aidancostello/ECE395_Project/README.md

# ECE395_Project

See report for directory layout and other information.
