aidancostello/ECE395_Project/Hardware/TrackingTurrentBoard/TrackingTurrentBoard.pdf

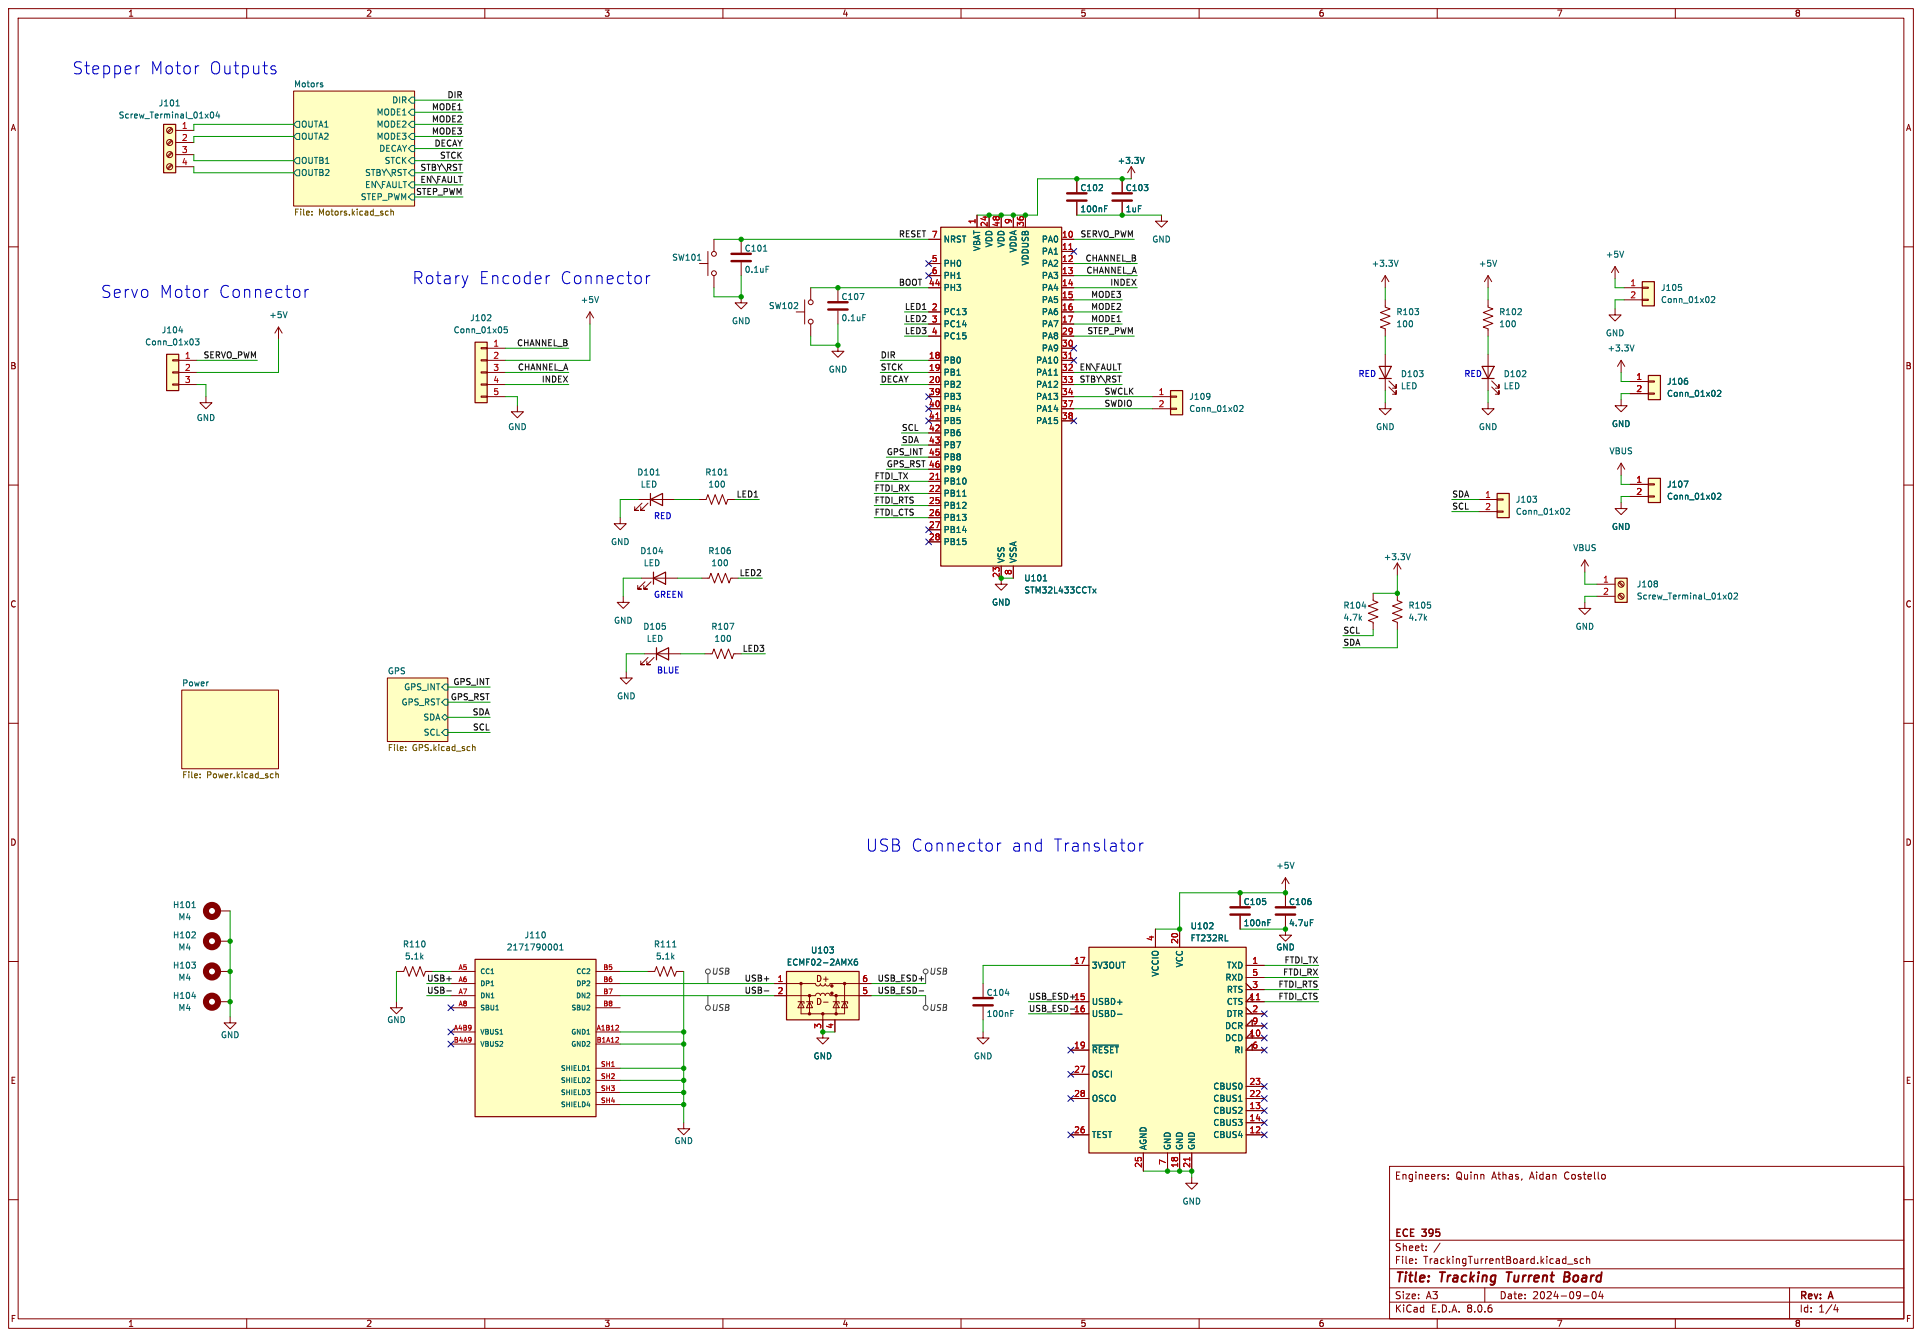
[picture p1: page 1]

EN\FAULT STBY\RST DIR
STCK MODE2 MODE1 STEP_PWM

1 PA0 10 PA1 11 PA2 12 PA3 13 PA4 14 PA5 15 PA6 16 PA7 17 PB0 18 PB1 19 PC13 2 PB2 20 PB10 21 PB11 22 VSS 23 VDD 24 PB12 25 PB13 26 PB14 27 PB15 28 PA8 29 PC14 3 PA9 30 PA10 31 PA11 32 PA12 33 PA13 34 VDDUSB 36 PA14 37 PA15 38 PB3 39 PC15 4 PB4 40 PB5 41 PB6 42 PB7 43 PH3 44 PB8 45 PB9 46 VDD 48 PH0 5 PH1 6 NRST 7 VSSA

9 U102 FT232RLTXD 1 DCD 10 CTS 11 CBUS4 12 CBUS2 13 CBUS3 14 USBD+ 15 USBD- 16

STBY\RST MODE2 EN\FAULT STEP_PWM

File: GPS.kicad_sch Power File: Power.kicad_sch

File: TrackingTurrentBoard.kicad_sch Sheet: / ECE 395 Engineers: Quinn Athas, Aidan Costello

Id: 1/4 Title: Tracking Turrent Board

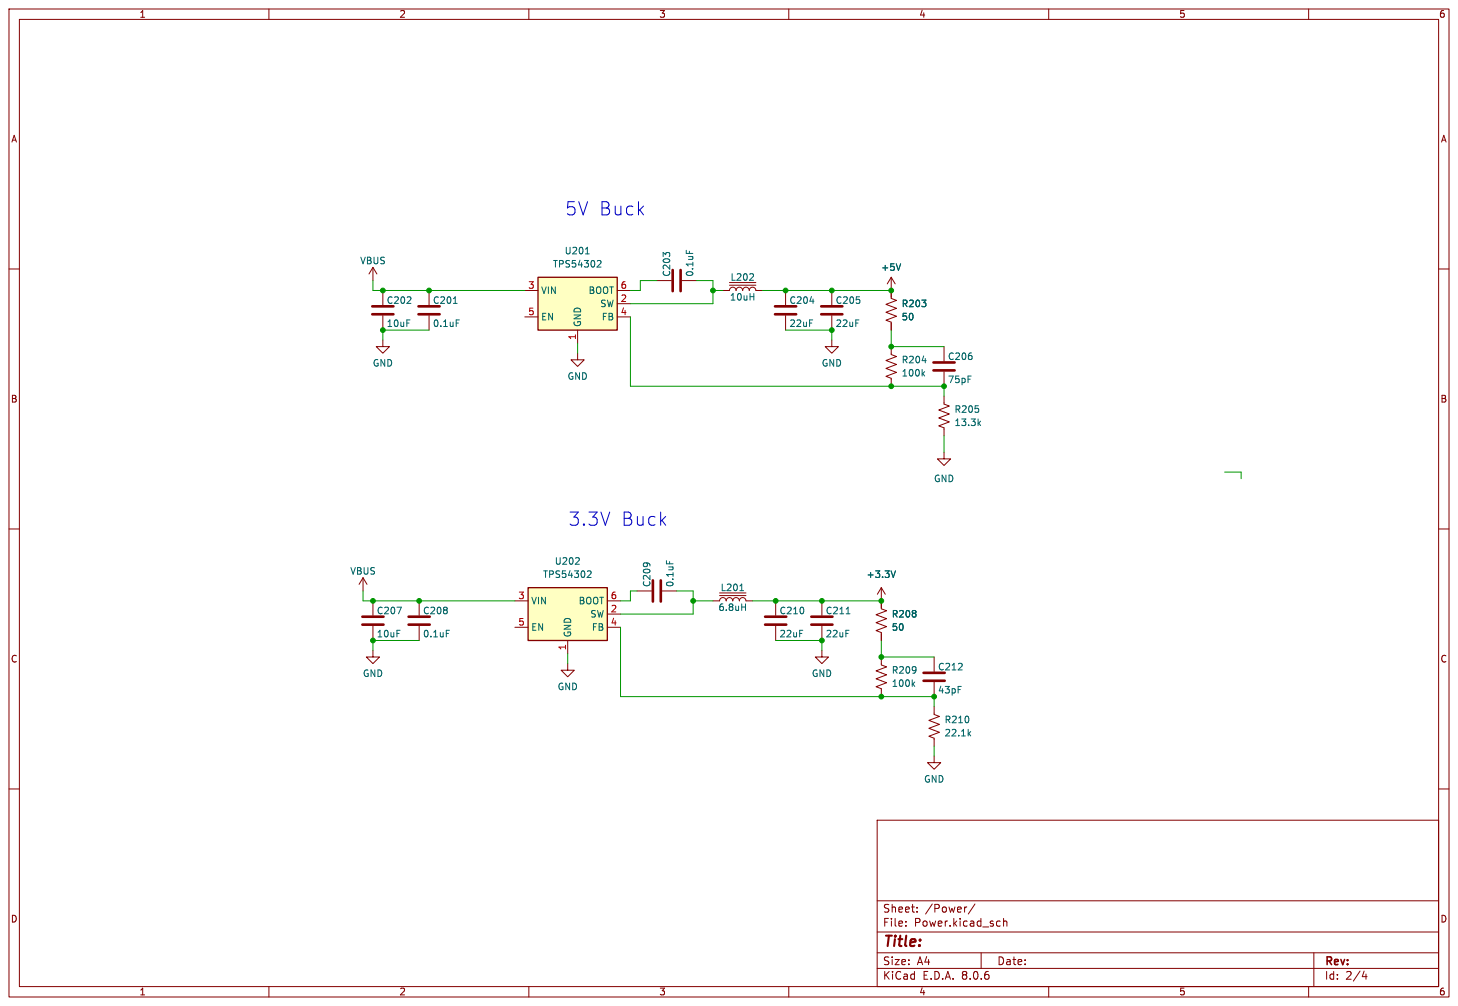
[picture p2: page 2]

1 SW 2 VIN 3 FB 4 EN 5 BOOT 6 U202 TPS54302 GND GND

Id: 2/4 Title: File: Power.kicad_sch Sheet: /Power/ R209

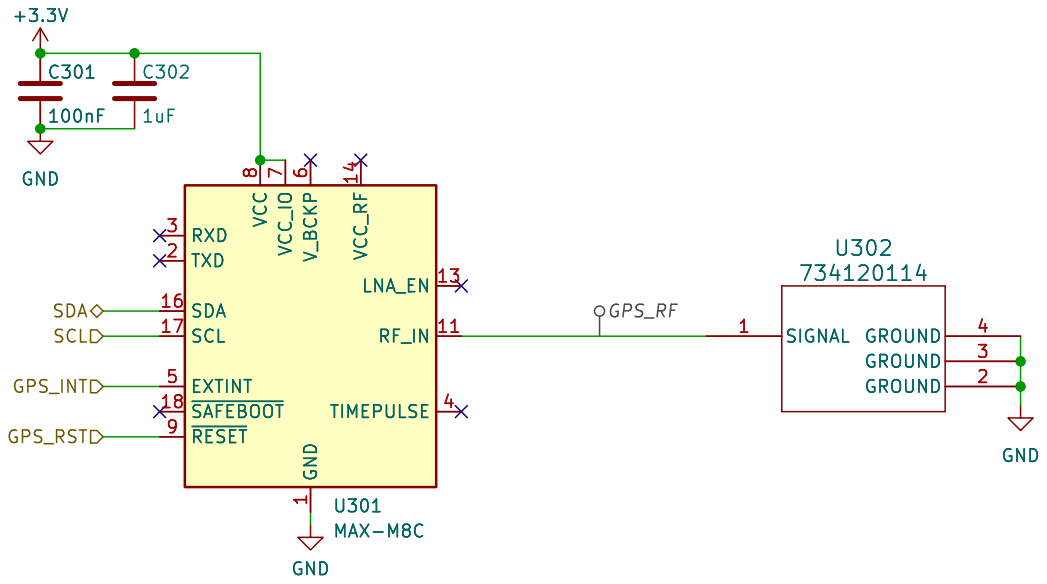
[picture p3: page 3]

Id: 3/4 Title: File: GPS.kicad_sch Sheet: /GPS/ GND

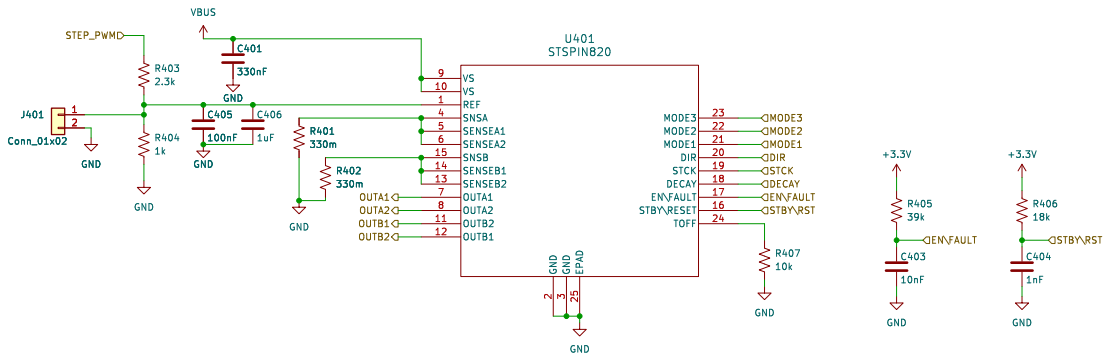
[picture p4: page 4]

2 TOFF 24 U401 STSPIN820 OUTB2 EN\FAULT STBY\RST MODE2 MODE1 MODE3 STEP_PWM
