aidancostello/ECE395_Project/Hardware/TrackingTurrentBoard/TrackingTurrentBoard.kicad_pcb

## KiCad design Hardware/TrackingTurrentBoard/TrackingTurrentBoard.kicad_pcb (2024-10-31)

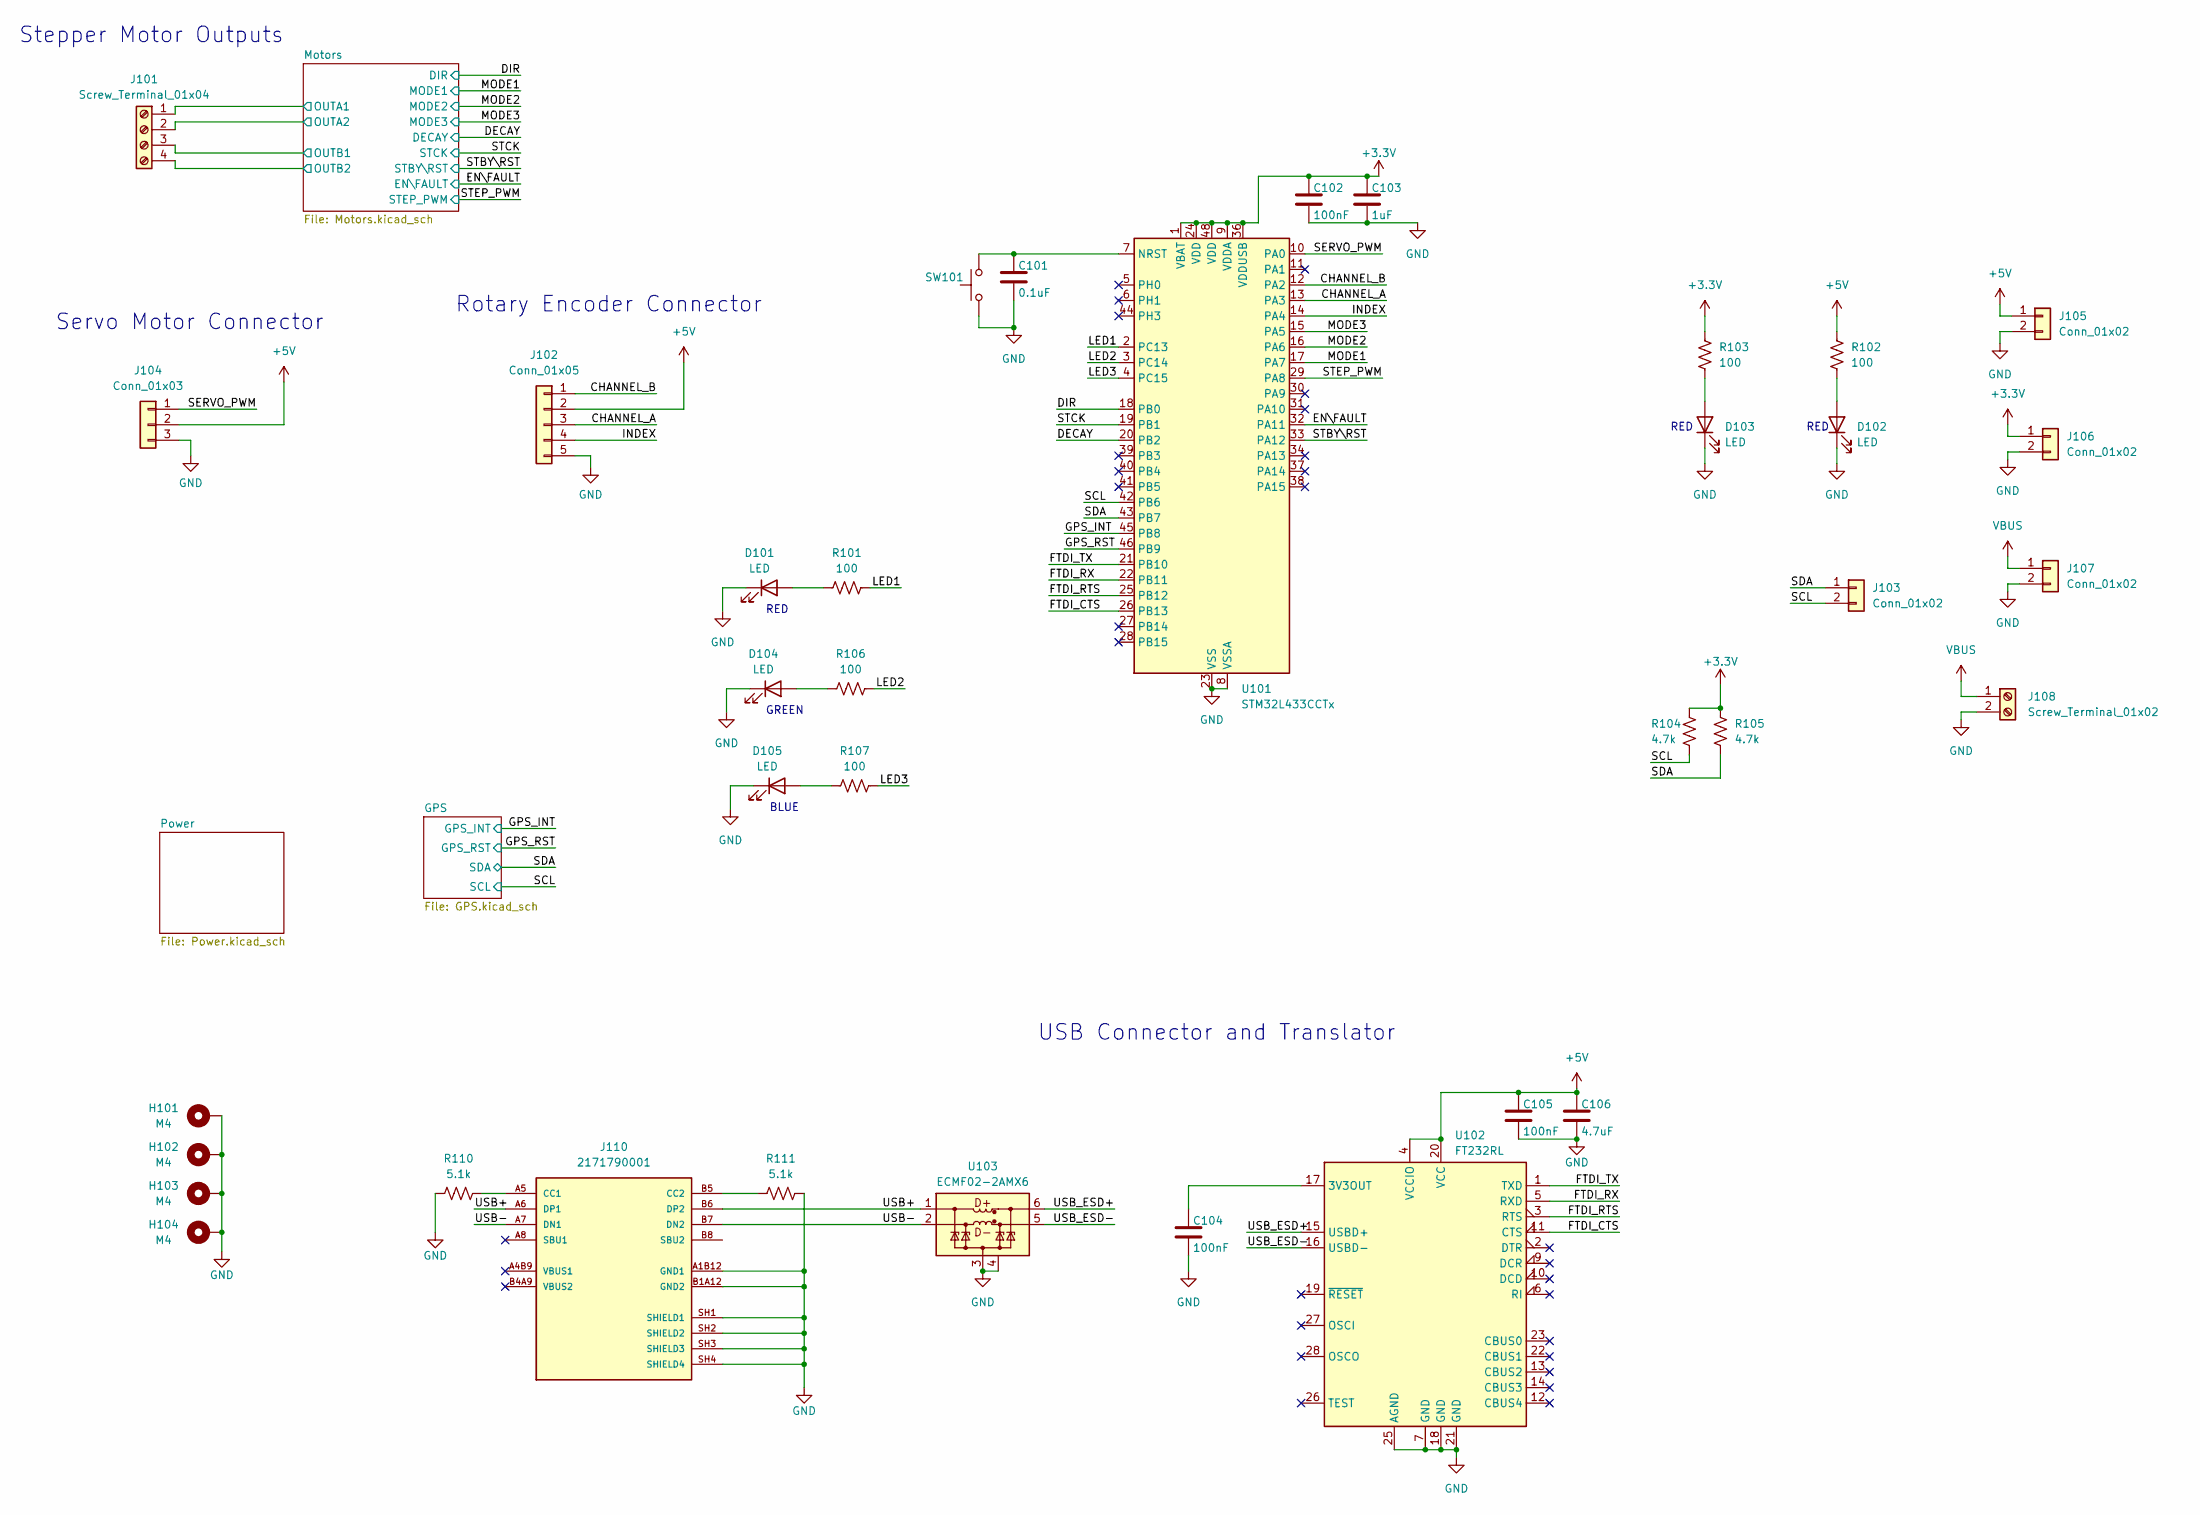
[picture p5: schematic TrackingTurrentBoard.kicad_sch, Tracking Turrent Board]

Parts:
C101: 0.1uF; C_0603_1608Metric
C102, C104, C105: 100nF; C_0603_1608Metric
C103: 1uF; C_0603_1608Metric
C106: 4.7uF; C_0603_1608Metric
D101, D102, D103, D104, D105: LED; LED_0603_1608Metric
H101, H102, H103, H104: M4; MountingHole_4.3mm_M4_Pad_Via
J101: Screw_Terminal_01x04; TerminalBlock_TE_282834-4_1x04_P2.54mm_Horizontal
J102: Conn_01x05; PinHeader_1x05_P2.54mm_Vertical
J103, J105, J106, J107: Conn_01x02; PinHeader_1x02_P2.54mm_Vertical
J104: Conn_01x03; PinHeader_1x03_P2.54mm_Vertical
J108: Screw_Terminal_01x02; TerminalBlock_TE_282834-2_1x02_P2.54mm_Horizontal
J110: 2171790001; MOLEX_2171790001; PARTREV A1
R101, R102, R103, R106, R107: 100; R_0603_1608Metric
R104, R105: 4.7k; R_0603_1608Metric
R110, R111: 5.1k; R_0603_1608Metric
SW101: SW_MEC_5G; SW_SPST_CK_RS282G05A3
U101: STM32L433CCTx; LQFP-48_7x7mm_P0.5mm
U102: FT232RL; SSOP-28_5.3x10.2mm_P0.65mm
U103: ECMF02-2AMX6; ST_UQFN-6L_1.5x1.7mm_P0.5mm

Connections:
+3.3V: C102.1, C103.1, J106.1, R103.2, R104.2, R105.2, U101.1 (VBAT), U101.9 (VDDA), U101.24 (VDD), U101.36 (VDDUSB), U101.48 (VDD); also elsewhere on the board
+5V: C105.1, C106.1, J102.2, J104.2, J105.1, R102.2, U102.4 (VCCIO), U102.20 (VCC); also elsewhere on the board
/CHANNEL_A: J102.3, U101.13 (PA3)
/CHANNEL_B: J102.1, U101.12 (PA2)
/DECAY: U101.20 (PB2); also elsewhere on the board
/DIR: U101.18 (PB0); also elsewhere on the board
/EN\FAULT: U101.32 (PA11); also elsewhere on the board
/FTDI_CTS: U101.26 (PB13), U102.11 (CTS)
/FTDI_RTS: U101.25 (PB12), U102.3 (RTS)
/FTDI_RX: U101.22 (PB11), U102.5 (RXD)
/FTDI_TX: U101.21 (PB10), U102.1 (TXD)
/GPS_INT: U101.45 (PB8); also elsewhere on the board
/GPS_RST: U101.46 (PB9); also elsewhere on the board
/INDEX: J102.4, U101.14 (PA4)
/LED1: R101.2, U101.2 (PC13)
/LED2: R106.2, U101.3 (PC14)
/LED3: R107.2, U101.4 (PC15)
/MODE1: U101.17 (PA7); also elsewhere on the board
/MODE2: U101.16 (PA6); also elsewhere on the board
/MODE3: U101.15 (PA5); also elsewhere on the board
/Motors/OUTA1: J101.1; also elsewhere on the board
/Motors/OUTA2: J101.2; also elsewhere on the board
/Motors/OUTB1: J101.3; also elsewhere on the board
/Motors/OUTB2: J101.4; also elsewhere on the board
/SCL: J103.2, R104.1, U101.42 (PB6); also elsewhere on the board
/SDA: J103.1, R105.1, U101.43 (PB7); also elsewhere on the board
/SERVO_PWM: J104.1, U101.10 (PA0)
/STBY\RST: U101.33 (PA12); also elsewhere on the board
/STCK: U101.19 (PB1); also elsewhere on the board
/STEP_PWM: U101.29 (PA8); also elsewhere on the board
/USB+: J110.A6 (DP1), J110.B6 (DP2), U103.1 (D+_in)
/USB-: J110.A7 (DN1), J110.B7 (DN2), U103.2 (D-_in)
/USB_ESD+: U102.15 (USBD+), U103.6 (D+_out)
/USB_ESD-: U102.16 (USBD-), U103.5 (D-_out)
GND: C101.2, C102.2, C103.2, C104.2, C105.2, C106.2, D101.1 (K), D102.1 (K), D103.1 (K), D104.1 (K), D105.1 (K), H101.1, H102.1, H103.1, H104.1, J102.5, J104.3, J105.2, J106.2, J107.2, J108.2, J110.A1B12 (GND1), J110.B1A12 (GND2), J110.SH1 (SHIELD1), J110.SH2 (SHIELD2), J110.SH3 (SHIELD3), J110.SH4 (SHIELD4), R110.1, R111.2, SW101.1 (A), U101.8 (VSSA), U101.23 (VSS), U101.35 (VSS), U101.47 (VSS), U102.7 (GND), U102.18 (GND), U102.21 (GND), U102.25 (AGND), U103.3 (GND), U103.4 (NC); also elsewhere on the board
unnamed: D101.2 (A), R101.1
unnamed: D102.2 (A), R102.1
unnamed: D103.2 (A), R103.1
unnamed: D104.2 (A), R106.1
unnamed: D105.2 (A), R107.1
unnamed: J110.A5 (CC1), R110.2
unnamed: J110.B5 (CC2), R111.1
unnamed: C101.1, SW101.2 (B), U101.7 (NRST)
unnamed: C104.1, U102.17 (3V3OUT)
VBUS: J107.1, J108.1; also elsewhere on the board

Notes on the sheet:
BLUE
GREEN
USB Connector and Translator
RED
Rotary Encoder Connector
Stepper Motor Outputs
Servo Motor Connector

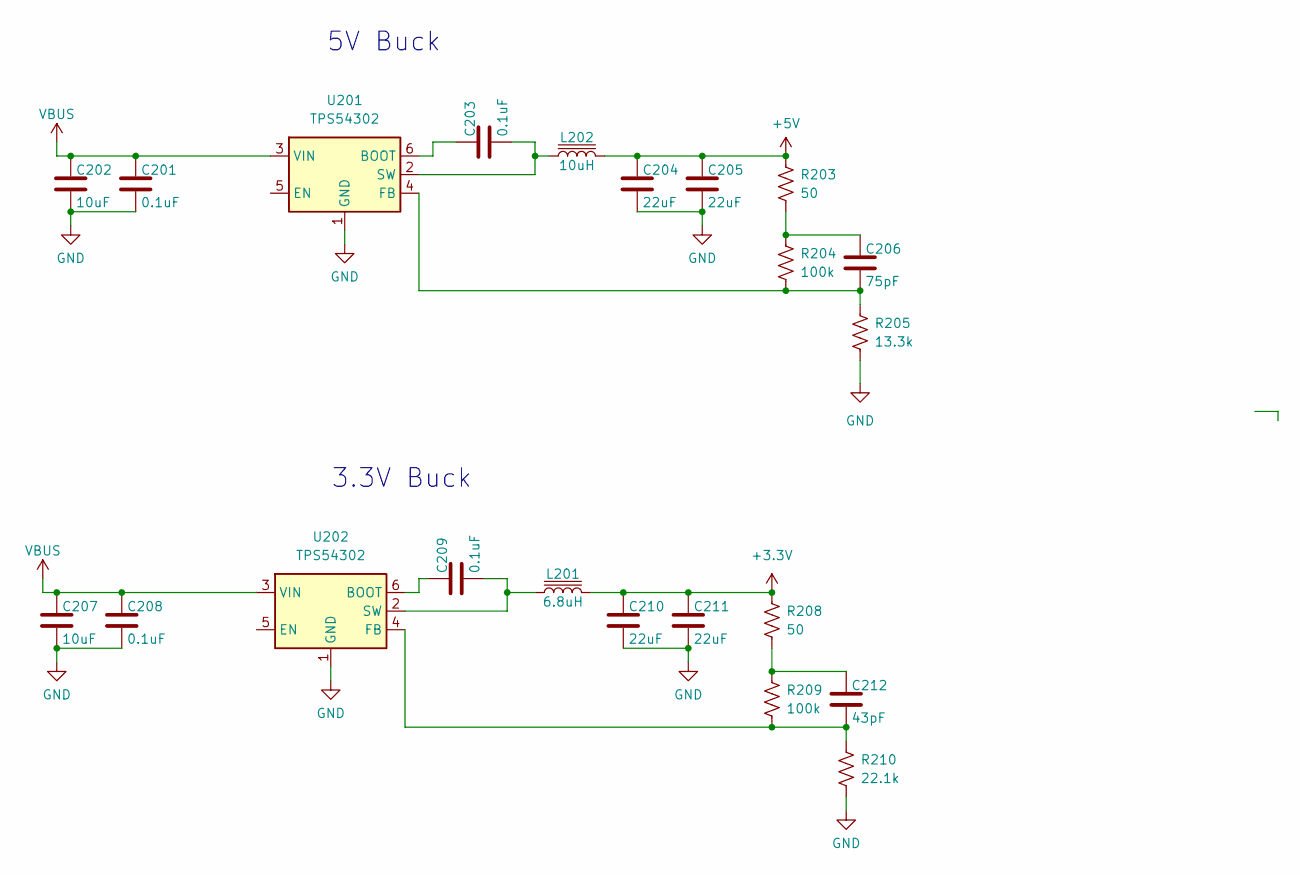
[picture p6: schematic Power.kicad_sch]

Parts:
C201, C203, C208, C209: 0.1uF; C_0603_1608Metric
C202, C207: 10uF; C_0603_1608Metric
C204, C205, C210, C211: 22uF; C_0603_1608Metric
C206: 75pF; C_0603_1608Metric
C212: 43pF; C_0603_1608Metric
L201: 6.8uH; IND_BOURNS_SRP1250
L202: 10uH; IND_BOURNS_SRP1250
R203, R208: 50; R_0603_1608Metric
R204, R209: 100k; R_0603_1608Metric
R205: 13.3k; R_0603_1608Metric
R210: 22.1k; R_0603_1608Metric
U201, U202: TPS54302; SOT-23-6

Connections:
+3.3V: C210.1, C211.1, L201.2, R208.1; also elsewhere on the board
+5V: C204.1, C205.1, L202.2, R203.1; also elsewhere on the board
GND: C201.2, C202.2, C204.2, C205.2, C207.2, C208.2, C210.2, C211.2, R205.2, R210.2, U201.1 (GND), U202.1 (GND); also elsewhere on the board
unnamed: C206.1, R203.2, R204.1
unnamed: C212.1, R208.2, R209.1
unnamed: C203.1, U201.6 (BOOT)
unnamed: C206.2, R204.2, R205.1, U201.4 (FB)
unnamed: C203.2, L202.1, U201.2 (SW)
unnamed: C209.1, U202.6 (BOOT)
unnamed: C212.2, R209.2, R210.1, U202.4 (FB)
unnamed: C209.2, L201.1, U202.2 (SW)
VBUS: C201.1, C202.1, C207.1, C208.1, U201.3 (VIN), U202.3 (VIN); also elsewhere on the board

Notes on the sheet:
3.3V Buck
5V Buck

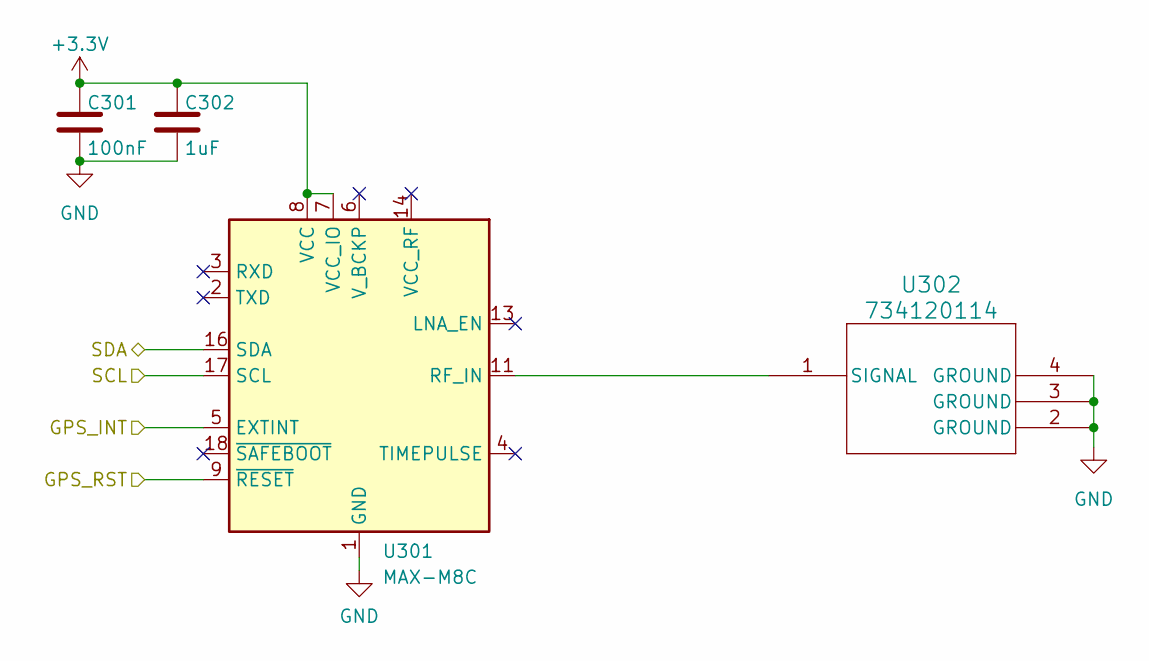
[picture p7: schematic GPS.kicad_sch]

Parts:
C301: 100nF; C_0603_1608Metric
C302: 1uF; C_0603_1608Metric
U301: MAX-M8C; ublox_MAX
U302: 734120114; 73412-0114_MOL

Connections:
+3.3V: C301.1, C302.1, U301.7 (VCC_IO), U301.8 (VCC); also elsewhere on the board
/GPS_INT: U301.5 (EXTINT); also elsewhere on the board
/GPS_RST: U301.9 (~RESET); also elsewhere on the board
/SCL: U301.17 (SCL); also elsewhere on the board
/SDA: U301.16 (SDA); also elsewhere on the board
GND: C301.2, C302.2, U301.1 (GND), U301.10 (GND), U301.12 (GND), U302.2 (GROUND), U302.3 (GROUND), U302.4 (GROUND); also elsewhere on the board
unnamed: U301.11 (RF_IN), U302.1 (SIGNAL)

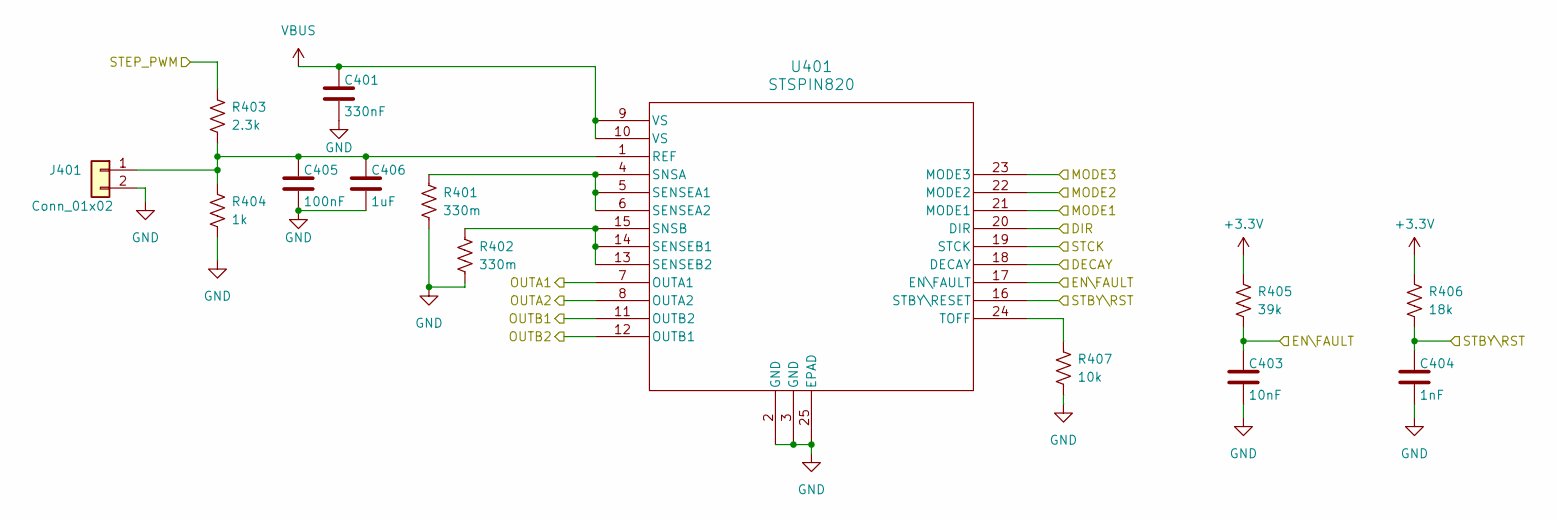
[picture p8: schematic Motors.kicad_sch]

Parts:
C401: 330nF; C_0603_1608Metric
C403: 10nF; C_0603_1608Metric
C404: 1nF; C_0603_1608Metric
C405: 100nF; C_0603_1608Metric
C406: 1uF; C_0603_1608Metric
J401: Conn_01x02; PinHeader_1x02_P2.54mm_Vertical
R401, R402: 330m; R_2512_6332Metric
R403: 2.3k; R_0603_1608Metric
R404: 1k; R_0603_1608Metric
R405: 39k; R_0603_1608Metric
R406: 18k; R_0603_1608Metric
R407: 10k; R_0603_1608Metric
U401: STSPIN820; QFN_SPIN820_STM

Connections:
+3.3V: R405.1, R406.1; also elsewhere on the board
/DECAY: U401.18 (DECAY); also elsewhere on the board
/DIR: U401.20 (DIR); also elsewhere on the board
/EN\FAULT: C403.1, R405.2, U401.17 (EN\FAULT); also elsewhere on the board
/MODE1: U401.21 (MODE1); also elsewhere on the board
/MODE2: U401.22 (MODE2); also elsewhere on the board
/MODE3: U401.23 (MODE3); also elsewhere on the board
/Motors/OUTA1: U401.7 (OUTA1); also elsewhere on the board
/Motors/OUTA2: U401.8 (OUTA2); also elsewhere on the board
/Motors/OUTB1: U401.11 (OUTB2); also elsewhere on the board
/Motors/OUTB2: U401.12 (OUTB1); also elsewhere on the board
/STBY\RST: C404.1, R406.2, U401.16 (STBY\RESET); also elsewhere on the board
/STCK: U401.19 (STCK); also elsewhere on the board
/STEP_PWM: R403.1; also elsewhere on the board
GND: C401.2, C403.2, C404.2, C405.2, C406.2, J401.2, R401.2, R402.2, R404.2, R407.2, U401.2 (GND), U401.3 (GND), U401.25 (EPAD); also elsewhere on the board
unnamed: C405.1, C406.1, J401.1, R403.2, R404.1, U401.1 (REF)
unnamed: R401.1, U401.4 (SNSA), U401.5 (SENSEA1), U401.6 (SENSEA2)
unnamed: R402.1, U401.13 (SENSEB2), U401.14 (SENSEB1), U401.15 (SNSB)
unnamed: R407.1, U401.24 (TOFF)
VBUS: C401.1, U401.9 (VS), U401.10 (VS); also elsewhere on the board

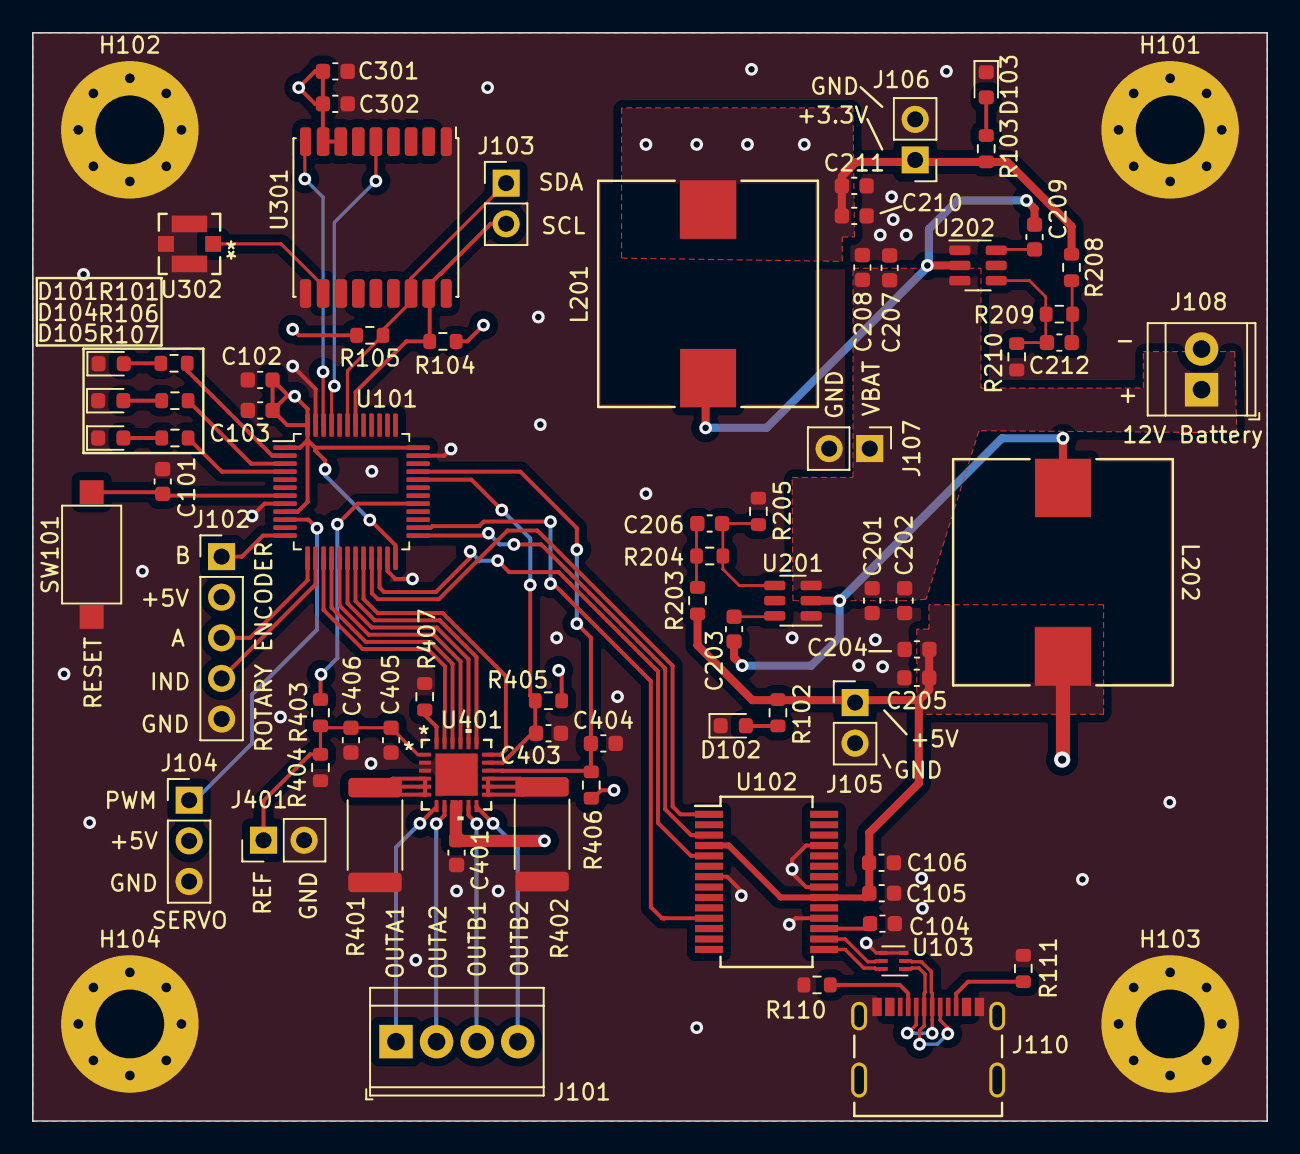
[picture p9: board TrackingTurrentBoard.kicad_pcb from above]

Board: 4 copper layers, 77.2 x 68.1 mm, 77 parts (0 on the bottom side), 58 nets.
