aidancostello/ECE395_Project/embedded_software/Core/Src/main.c

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
/* Includes ------------------------------------------------------------------*/
#include "main.h"
#include "cmsis_os.h"

/* USER CODE BEGIN Includes */
#include "structs.h"
#include "logging.h"
#include "log_config.h"
#include "self_gps.h"
#include "target_gps.h"
#include "calculate.h"
#include "encoder.h"
#include "stepper.h"
#include "servo.h"
/* USER CODE END Includes */

typedef StaticTask_t osStaticThreadDef_t;
typedef StaticQueue_t osStaticMessageQDef_t;
typedef StaticSemaphore_t osStaticMutexDef_t;
I2C_HandleTypeDef hi2c1;

UART_HandleTypeDef hlpuart1;
DMA_HandleTypeDef hdma_lpuart_rx;

TIM_HandleTypeDef htim2;

/* Definitions for task_SelfGps */
osThreadId_t task_SelfGpsHandle;
uint32_t task_SelfGpsBuffer[ 512 ];
osStaticThreadDef_t task_SelfGpsControlBlock;
const osThreadAttr_t task_SelfGps_attributes = {
  .name = "task_SelfGps",
  .cb_mem = &task_SelfGpsControlBlock,
  .cb_size = sizeof(task_SelfGpsControlBlock),
  .stack_mem = &task_SelfGpsBuffer[0],
  .stack_size = sizeof(task_SelfGpsBuffer),
  .priority = (osPriority_t) osPriorityNormal,
};
/* Definitions for task_TargetGps */
osThreadId_t task_TargetGpsHandle;
uint32_t task_TargetGpsBuffer[ 512 ];
osStaticThreadDef_t task_TargetGpsControlBlock;
const osThreadAttr_t task_TargetGps_attributes = {
  .name = "task_TargetGps",
  .cb_mem = &task_TargetGpsControlBlock,
  .cb_size = sizeof(task_TargetGpsControlBlock),
  .stack_mem = &task_TargetGpsBuffer[0],
  .stack_size = sizeof(task_TargetGpsBuffer),
  .priority = (osPriority_t) osPriorityNormal,
};
/* Definitions for task_Calculate */
osThreadId_t task_CalculateHandle;
uint32_t task_CalculateBuffer[ 512 ];
osStaticThreadDef_t task_CalculateControlBlock;
const osThreadAttr_t task_Calculate_attributes = {
  .name = "task_Calculate",
  .cb_mem = &task_CalculateControlBlock,
  .cb_size = sizeof(task_CalculateControlBlock),
  .stack_mem = &task_CalculateBuffer[0],
  .stack_size = sizeof(task_CalculateBuffer),
  .priority = (osPriority_t) osPriorityNormal,
};
/* Definitions for task_Encoder */
osThreadId_t task_EncoderHandle;
uint32_t task_EncoderBuffer[ 512 ];
osStaticThreadDef_t task_EncoderControlBlock;
const osThreadAttr_t task_Encoder_attributes = {
  .name = "task_Encoder",
  .cb_mem = &task_EncoderControlBlock,
  .cb_size = sizeof(task_EncoderControlBlock),
  .stack_mem = &task_EncoderBuffer[0],
  .stack_size = sizeof(task_EncoderBuffer),
  .priority = (osPriority_t) osPriorityNormal,
};
/* Definitions for task_Stepper */
osThreadId_t task_StepperHandle;
uint32_t task_StepperBuffer[ 512 ];
osStaticThreadDef_t task_StepperControlBlock;
const osThreadAttr_t task_Stepper_attributes = {
  .name = "task_Stepper",
  .cb_mem = &task_StepperControlBlock,
  .cb_size = sizeof(task_StepperControlBlock),
  .stack_mem = &task_StepperBuffer[0],
  .stack_size = sizeof(task_StepperBuffer),
  .priority = (osPriority_t) osPriorityNormal,
};
/* Definitions for task_Servo */
osThreadId_t task_ServoHandle;
uint32_t task_ServoBuffer[ 512 ];
osStaticThreadDef_t task_ServoControlBlock;
const osThreadAttr_t task_Servo_attributes = {
  .name = "task_Servo",
  .cb_mem = &task_ServoControlBlock,
  .cb_size = sizeof(task_ServoControlBlock),
  .stack_mem = &task_ServoBuffer[0],
  .stack_size = sizeof(task_ServoBuffer),
  .priority = (osPriority_t) osPriorityNormal,
};
/* Definitions for targetGpsQueue */
osMessageQueueId_t targetGpsQueueHandle;
uint8_t targetGpsQueueBuffer[ 8 * sizeof( struct TargetGpsDataRaw ) ];
osStaticMessageQDef_t targetGpsQueueControlBlock;
const osMessageQueueAttr_t targetGpsQueue_attributes = {
  .name = "targetGpsQueue",
  .cb_mem = &targetGpsQueueControlBlock,
  .cb_size = sizeof(targetGpsQueueControlBlock),
  .mq_mem = &targetGpsQueueBuffer,
  .mq_size = sizeof(targetGpsQueueBuffer)
};
/* Definitions for uartMutex */
osMutexId_t uartMutexHandle;
osStaticMutexDef_t uartMutexControlBlock;
const osMutexAttr_t uartMutex_attributes = {
  .name = "uartMutex",
  .cb_mem = &uartMutexControlBlock,
  .cb_size = sizeof(uartMutexControlBlock),
};
/* Definitions for gpsDataMutex */
osMutexId_t gpsDataMutexHandle;
osStaticMutexDef_t gpsDataMutexControlBlock;
const osMutexAttr_t gpsDataMutex_attributes = {
  .name = "gpsDataMutex",
  .cb_mem = &gpsDataMutexControlBlock,
  .cb_size = sizeof(gpsDataMutexControlBlock),
};
/* Definitions for targetPositionMutex */
osMutexId_t targetPositionMutexHandle;
osStaticMutexDef_t targetPositionMutexControlBlock;
const osMutexAttr_t targetPositionMutex_attributes = {
  .name = "targetPositionMutex",
  .cb_mem = &targetPositionMutexControlBlock,
  .cb_size = sizeof(targetPositionMutexControlBlock),
};
/* Definitions for encoderPositionMutex */
osMutexId_t encoderPositionMutexHandle;
osStaticMutexDef_t encoderPositionMutexControlBlock;
const osMutexAttr_t encoderPositionMutex_attributes = {
  .name = "encoderPositionMutex",
  .cb_mem = &encoderPositionMutexControlBlock,
  .cb_size = sizeof(encoderPositionMutexControlBlock),
};
/* USER CODE BEGIN PV */

uint8_t uart_rx_buf[24];

struct GpsData gps_data;
struct TargetPosition target_position;
struct EncoderPosition encoder_position;
struct DataPointers data_pointers;

/* USER CODE END PV */

void SystemClock_Config(void);
static void MX_GPIO_Init(void);
static void MX_DMA_Init(void);
static void MX_I2C1_Init(void);
static void MX_TIM2_Init(void);
static void MX_LPUART1_UART_Init(void);
void task_entry_SelfGps(void *argument);
void task_entry_TargetGps(void *argument);
void task_entry_Calculate(void *argument);
void task_entry_Encoder(void *argument);
void task_entry_Stepper(void *argument);
void task_entry_Servo(void *argument);

/**
  * @brief  The application entry point.
  * @retval int
  */
int main(void)
{

  /* MCU Configuration--------------------------------------------------------*/

  /* Reset of all peripherals, Initializes the Flash interface and the Systick. */
  HAL_Init();

  /* Configure the system clock */
  SystemClock_Config();

  /* Initialize all configured peripherals */
  MX_GPIO_Init();
  MX_DMA_Init();
  MX_I2C1_Init();
  MX_TIM2_Init();
  MX_LPUART1_UART_Init();
  /* Init scheduler */
  osKernelInitialize();
  /* Create the mutex(es) */
  /* creation of uartMutex */
  uartMutexHandle = osMutexNew(&uartMutex_attributes);

  /* creation of gpsDataMutex */
  gpsDataMutexHandle = osMutexNew(&gpsDataMutex_attributes);

  /* creation of targetPositionMutex */
  targetPositionMutexHandle = osMutexNew(&targetPositionMutex_attributes);

  /* creation of encoderPositionMutex */
  encoderPositionMutexHandle = osMutexNew(&encoderPositionMutex_attributes);

  /* USER CODE BEGIN RTOS_MUTEX */
  
  // fill gps data struct
  gps_data.self_lat = 0;
  gps_data.self_lon = 0;
  gps_data.self_alt = 0;
  gps_data.target_lat = 0;
  gps_data.target_lon = 0;
  gps_data.target_alt = 0;
  gps_data.mtx = &gpsDataMutexHandle;

  // fill target position struct
  target_position.elevation_angle = 0;
  target_position.rotation_angle = 0;
  target_position.mtx = &targetPositionMutexHandle;

  // fill encoder position struct
  encoder_position.rotation_angle = 0;
  encoder_position.mtx = &encoderPositionMutexHandle;

  // fill data pointers struct
  data_pointers.gps_data = &gps_data;
  data_pointers.target_position = &target_position;
  data_pointers.encoder_position = &encoder_position;

  log_init(&hlpuart1, &uartMutexHandle);

  /* USER CODE END RTOS_MUTEX */

  /* USER CODE BEGIN RTOS_SEMAPHORES */
  /* add semaphores, ... */
  /* USER CODE END RTOS_SEMAPHORES */

  /* USER CODE BEGIN RTOS_TIMERS */
  /* start timers, add new ones, ... */
  /* USER CODE END RTOS_TIMERS */

  /* Create the queue(s) */
  /* creation of targetGpsQueue */
  targetGpsQueueHandle = osMessageQueueNew (8, sizeof(struct TargetGpsDataRaw), &targetGpsQueue_attributes);

  /* USER CODE BEGIN RTOS_QUEUES */
  /* add queues, ... */
  /* USER CODE END RTOS_QUEUES */

  /* Create the thread(s) */
  /* creation of task_SelfGps */
  task_SelfGpsHandle = osThreadNew(task_entry_SelfGps, (void*) &data_pointers, &task_SelfGps_attributes);

  /* creation of task_TargetGps */
  task_TargetGpsHandle = osThreadNew(task_entry_TargetGps, (void*) &data_pointers, &task_TargetGps_attributes);

  /* creation of task_Calculate */
  task_CalculateHandle = osThreadNew(task_entry_Calculate, (void*) &data_pointers, &task_Calculate_attributes);

  /* creation of task_Encoder */
  // task_EncoderHandle = osThreadNew(task_entry_Encoder, (void*) &data_pointers, &task_Encoder_attributes);

  /* creation of task_Stepper */
  task_StepperHandle = osThreadNew(task_entry_Stepper, (void*) &data_pointers, &task_Stepper_attributes);

  /* creation of task_Servo */
  task_ServoHandle = osThreadNew(task_entry_Servo, (void*) &data_pointers, &task_Servo_attributes);

  /* USER CODE BEGIN RTOS_THREADS */
  /* add threads, ... */
  /* USER CODE END RTOS_THREADS */

  /* USER CODE BEGIN RTOS_EVENTS */
  HAL_UART_Receive_DMA(&hlpuart1, uart_rx_buf, 24);
  /* USER CODE END RTOS_EVENTS */

  /* Start scheduler */
  osKernelStart();

  /* We should never get here as control is now taken by the scheduler */

  /* Infinite loop */
  /* USER CODE BEGIN WHILE */
  while (1)
  {
    /* USER CODE END WHILE */

    /* USER CODE BEGIN 3 */
  }
  /* USER CODE END 3 */
}

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
/* USER CODE BEGIN Header_task_entry_SelfGps */
/**
  * @brief  Function implementing the task_SelfGps thread.
  * @param  argument: Not used
  * @retval None
  */
/* USER CODE END Header_task_entry_SelfGps */
void task_entry_SelfGps(void *argument)
{
  /* USER CODE BEGIN 5 */
  self_gps_init(&hi2c1);
  uint8_t i = 0;
  /* Infinite loop */
  for(;;)
  {
    #ifdef LOG_THREAD_ENTRY
    log_print("task 1\n");
    #endif

    if (i == 100) {
      HAL_GPIO_TogglePin(LED2_BANK, LED2_PIN);
      i = 0;
    }
    else {
      i++;
    }

    self_gps_update(&hi2c1, ((struct DataPointers*)argument)->gps_data);

    osDelay(10);
  }
  /* USER CODE END 5 */
}

/* USER CODE BEGIN Header_task_entry_TargetGps */
/**
* @brief Function implementing the task_TargetGps thread.
* @param argument: Not used
* @retval None
*/
/* USER CODE END Header_task_entry_TargetGps */
void task_entry_TargetGps(void *argument)
{
  /* USER CODE BEGIN task_entry_TargetGps */
  target_gps_init();
  /* Infinite loop */
  for(;;)
  {
    #ifdef LOG_THREAD_ENTRY
    log_print("task 2\n");
    #endif

    target_gps_update(&targetGpsQueueHandle, ((struct DataPointers*)argument)->gps_data);

    osDelay(10);
  }
  /* USER CODE END task_entry_TargetGps */
}

/* USER CODE BEGIN Header_task_entry_Calculate */
/**
* @brief Function implementing the task_Calculate thread.
* @param argument: Not used
* @retval None
*/
/* USER CODE END Header_task_entry_Calculate */
void task_entry_Calculate(void *argument)
{
  /* USER CODE BEGIN task_entry_Calculate */
  /* Infinite loop */
  for(;;)
  {
    #ifdef LOG_THREAD_ENTRY
    log_print("task 3\n");
    #endif

    calculate_update(((struct DataPointers*)argument)->gps_data, ((struct DataPointers*)argument)->target_position);

    osDelay(10);
  }
  /* USER CODE END task_entry_Calculate */
}

/* USER CODE BEGIN Header_task_entry_Encoder */
/**
* @brief Function implementing the task_Encoder thread.
* @param argument: Not used
* @retval None
*/
/* USER CODE END Header_task_entry_Encoder */
void task_entry_Encoder(void *argument)
{
  /* USER CODE BEGIN task_entry_Encoder */
  encoder_init();
  /* Infinite loop */
  for(;;)
  {
    #ifdef LOG_THREAD_ENTRY
    log_print("task 4\n");
    #endif

    encoder_update(((struct DataPointers*)argument)->encoder_position);

    osDelay(10);
  }
  /* USER CODE END task_entry_Encoder */
}

/* USER CODE BEGIN Header_task_entry_Stepper */
/**
* @brief Function implementing the task_Stepper thread.
* @param argument: Not used
* @retval None
*/
/* USER CODE END Header_task_entry_Stepper */
void task_entry_Stepper(void *argument)
{
  /* USER CODE BEGIN task_entry_Stepper */
  stepper_init();
  /* Infinite loop */
  for(;;)
  {
    #ifdef LOG_THREAD_ENTRY
    log_print("task 5\n");
    #endif

    stepper_update(((struct DataPointers*)argument)->encoder_position, ((struct DataPointers*)argument)->target_position);

    osDelay(10);
  }
  /* USER CODE END task_entry_Stepper */
}

/* USER CODE BEGIN Header_task_entry_Servo */
/**
* @brief Function implementing the task_Servo thread.
* @param argument: Not used
* @retval None
*/
/* USER CODE END Header_task_entry_Servo */
void task_entry_Servo(void *argument)
{
  /* USER CODE BEGIN task_entry_Servo */
  servo_init(&htim2);
  /* Infinite loop */
  for(;;)
  {
    #ifdef LOG_THREAD_ENTRY
    log_print("task 6\n");
    #endif

    servo_update(&htim2, ((struct DataPointers*)argument)->target_position);

    osDelay(10);
  }
  /* USER CODE END task_entry_Servo */
}

// once received 24 bytes, remove from buffer and put into queue
void HAL_UART_RxCpltCallback(UART_HandleTypeDef *huart)
{
  struct TargetGpsDataRaw data_packet;

  // fill data
  memcpy(&data_packet.target_lat, uart_rx_buf, 8);
  memcpy(&data_packet.target_lon, uart_rx_buf+8, 8);
  memcpy(&data_packet.target_alt, uart_rx_buf+16, 8);

  // reset rx buf
  memset(uart_rx_buf, 0, 24);

  // place data in queue
  osMessageQueuePut(targetGpsQueueHandle, &data_packet, 0, 0);
}

/**
  * @brief  Period elapsed callback in non blocking mode
  * @note   This function is called  when TIM6 interrupt took place, inside
  * HAL_TIM_IRQHandler(). It makes a direct call to HAL_IncTick() to increment
  * a global variable "uwTick" used as application time base.
  * @param  htim : TIM handle
  * @retval None
  */
void HAL_TIM_PeriodElapsedCallback(TIM_HandleTypeDef *htim)
{
  if (htim->Instance == TIM6) {
    HAL_IncTick();
  }
}

/**
  * @brief  This function is executed in case of error occurrence.
  * @retval None
  */
void Error_Handler(void)
{
  /* USER CODE BEGIN Error_Handler_Debug */
  /* User can add his own implementation to report the HAL error return state */
  __disable_irq();
  while (1)
  {
  }
  /* USER CODE END Error_Handler_Debug */
}

#ifdef  USE_FULL_ASSERT
/**
  * @brief  Reports the name of the source file and the source line number
  *         where the assert_param error has occurred.
  * @param  file: pointer to the source file name
  * @param  line: assert_param error line source number
  * @retval None
  */
void assert_failed(uint8_t *file, uint32_t line)
{
  /* USER CODE BEGIN 6 */
  /* User can add his own implementation to report the file name and line number,
     ex: printf("Wrong parameters value: file %s on line %d\r\n", file, line) */
  /* USER CODE END 6 */
}
#endif /* USE_FULL_ASSERT */
