aidancostello/ECE395_Project/embedded_software/Threads/Inc/target_gps.h

#ifndef __TARGET_GPS_H
#define __TARGET_GPS_H

#include "structs.h"
#include "stm32l4xx_hal.h"
#include "pins.h"

#define SCALAR 10000.0

void target_gps_init();

void target_gps_update(osMessageQueueId_t* uart_queue, struct GpsData* gps_data);

#endif
