aidancostello/ECE395_Project/scripts/demo/constants.py

# default location coordinates
DEFAULT_LAT = 40.115
DEFAULT_LON = -88.227778
DEFAULT_ALT = 228.6

# serial constants
PORT = "/dev/tty.usbserial-A50285BI"
BAUD = 115200

# scalars
SERIAL_SCALAR = 10000

# max values
ALT_MAX= 100000
