aidancostello/ECE395_Project/(commit log)

2024-09-04 inital KiCad project added
    [TrackingTurrentBoard.kicad_pcb, TrackingTurrentBoard.kicad_sch]
2024-09-06 added symbols and started power circuits
    [Connectors.kicad_sch, GPS.kicad_sch, Motors.kicad_sch, Power.kicad_sch, TrackingTurrentBoard.kicad_sch]
2024-09-11 added buck sch
    [Power.kicad_sch, TrackingTurrentBoard.kicad_sch]
2024-10-22 updated pin definitions
2024-10-25 python tests for stepper and calculations
2024-10-25 barebones uart receiving
2024-10-31 PCB done
    [GPS.kicad_sch, Motors.kicad_sch, Power.kicad_sch, TrackingTurrentBoard (version 1).xlsb.csv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]
2024-11-05 added uart mutex
2024-11-12 uart receive dma
2024-11-16 fixed mutex issue, added logging library
    [calculate.c, encoder.c, logging.c, logging.h, main.c, self_gps.c, servo.c]
2024-11-21 switched to lpuart1
2024-12-04 commented out encoder thread, not necessary
2024-12-17 most recent pcb and sch
    [TrackingTurrentBoard.kicad_sch]
